pravinsharma15k-ops/ESP32-C3-Sensor-Board/ESP32-project/image/Screenshot from 2026-10-27 00-12-24.png

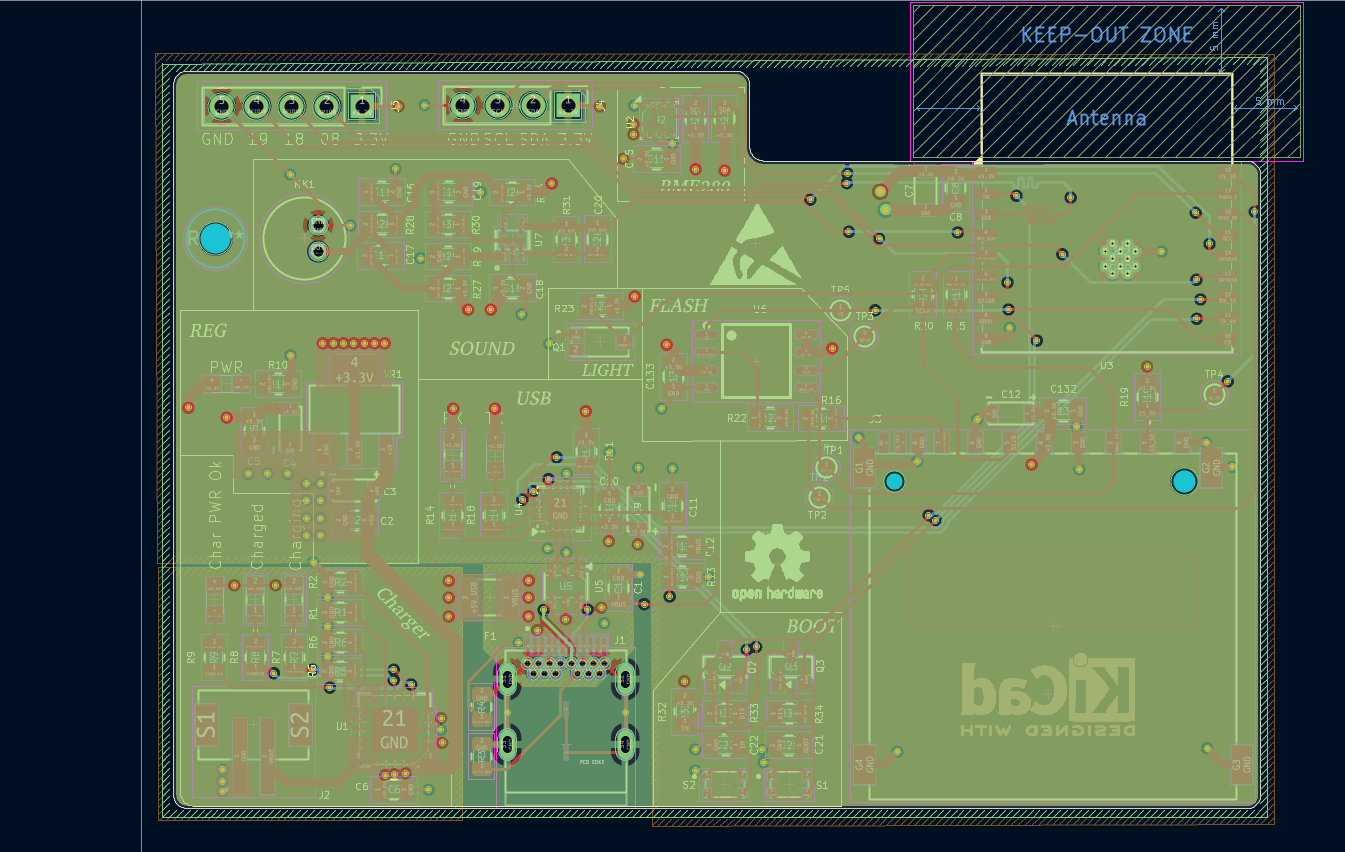
ESP32-project/image/Screenshot from 2026-10-27 00-12-24.png
