pravinsharma15k-ops/ESP32-C3-Sensor-Board/image/Screenshot from 2026-10-26 23-48-33.png

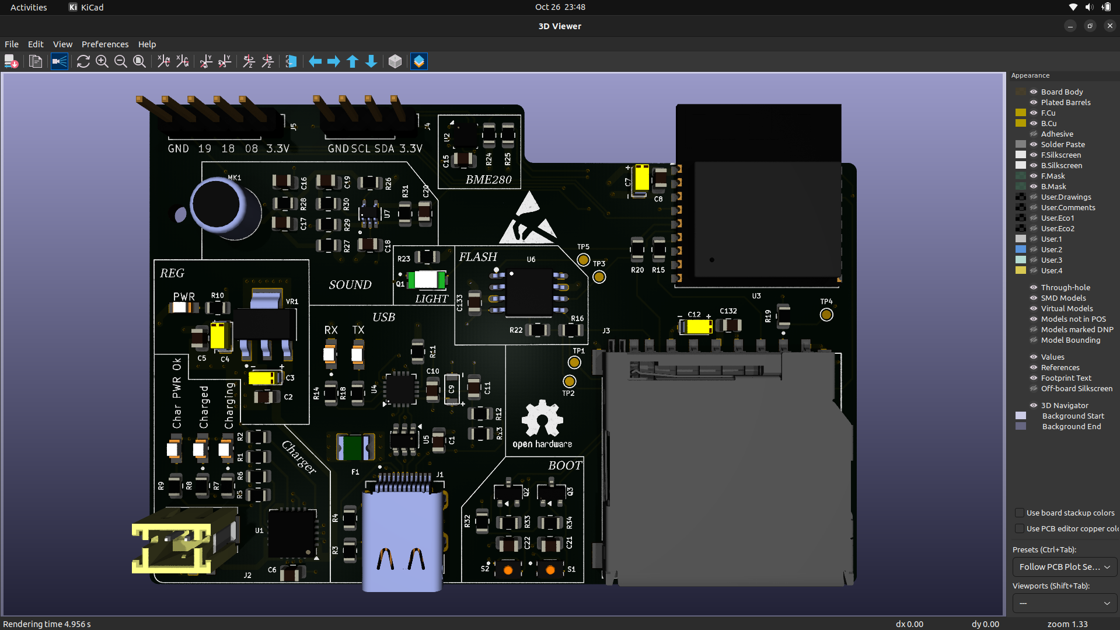
image/Screenshot from 2026-10-26 23-48-33.png
