pravinsharma15k-ops/ESP32-C3-Sensor-Board/image/Screenshot from 2026-10-27 00-13-16.png

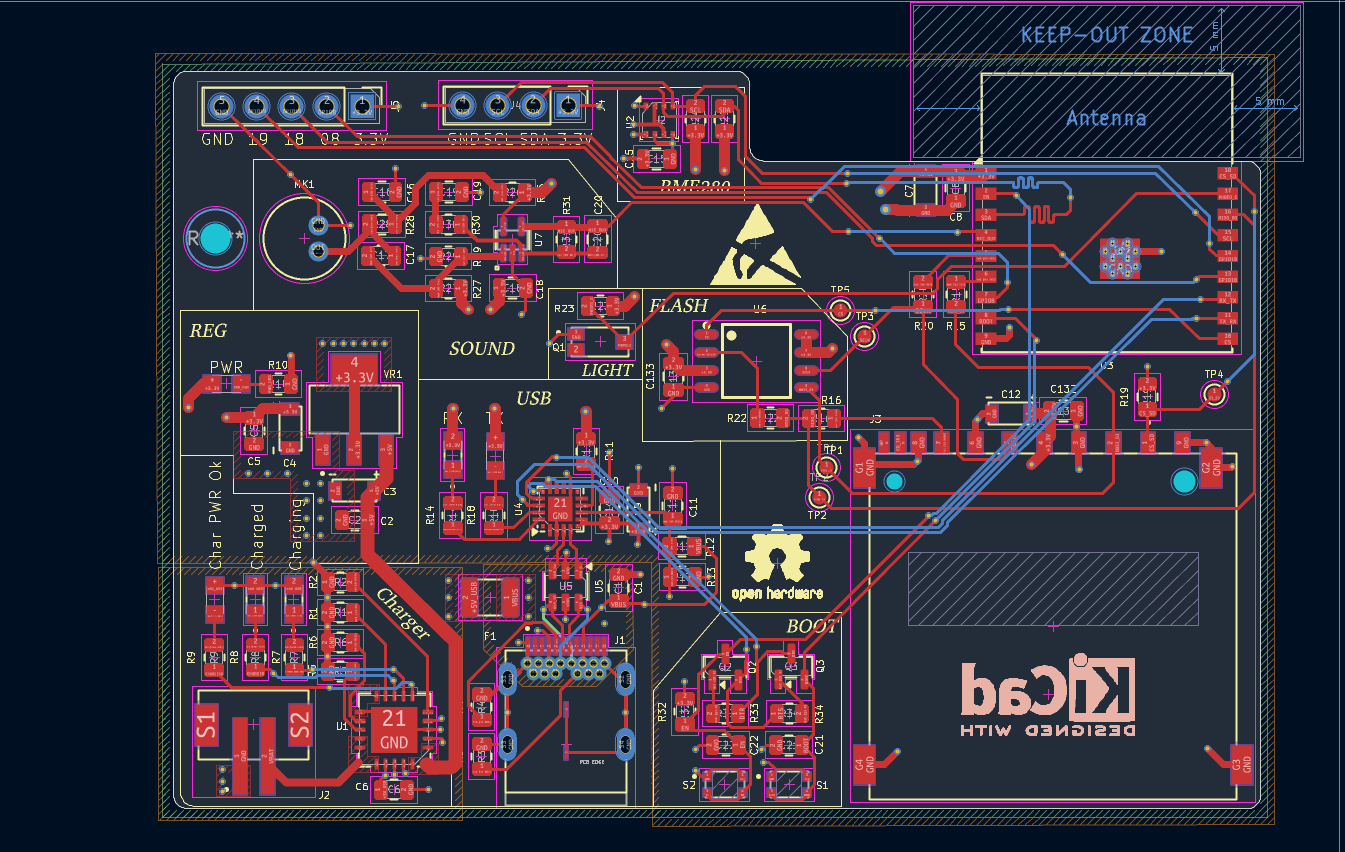
image/Screenshot from 2026-10-27 00-13-16.png
