pravinsharma15k-ops/ESP32-C3-Sensor-Board/Project_Library/Screenshot from 2026-10-22 23-52-42.png

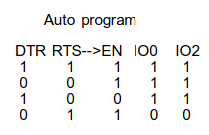
Project_Library/Screenshot from 2026-10-22 23-52-42.png
