pravinsharma15k-ops/ESP32-C3-Sensor-Board/Project_Library/3D-model/0ZCH0110AF2E.step

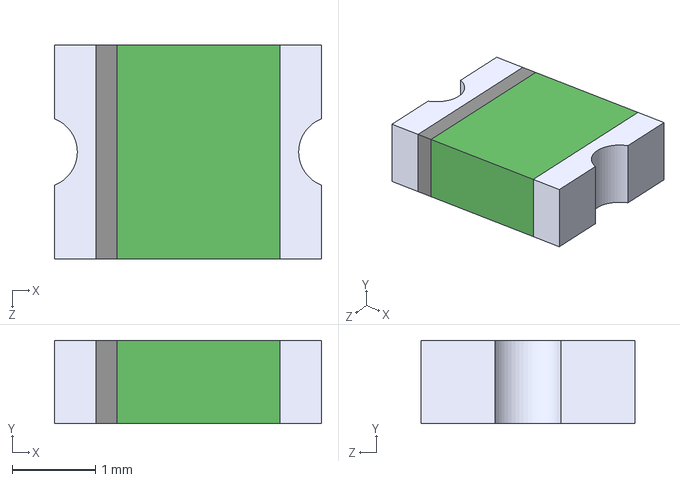
[picture p14: CAD file, 2026-10-26]
Project_Library/3D-model/0ZCH0110AF2E.step
3.21 x 1.00 x 2.58 mm
