pravinsharma15k-ops/ESP32-C3-Sensor-Board/Project_Library/3D-model/CMC-5042PF-AC.step

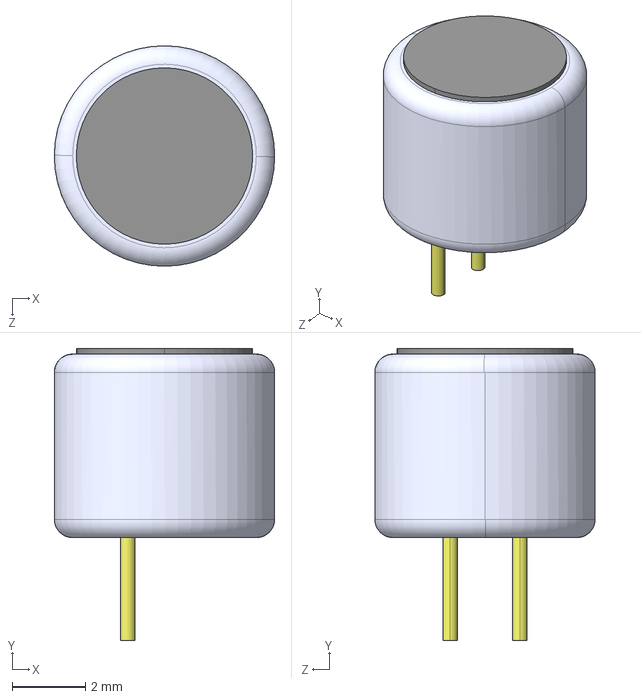
[picture p15: CAD file, 2026-10-26]
Project_Library/3D-model/CMC-5042PF-AC.step
6.00 x 7.95 x 6.00 mm
