pravinsharma15k-ops/ESP32-C3-Sensor-Board/ESP32-project_log_missing3Dmodels.txt

[('U4', '/usr/share/kicad/3dmodels/Package_DFN_QFN.3dshapes/SiliconLabs_QFN-20-1EP_3x3mm_P0.5mm_EP1.8x1.8mm.step')]
