pravinsharma15k-ops/ESP32-C3-Sensor-Board/ESP32-project.pdf

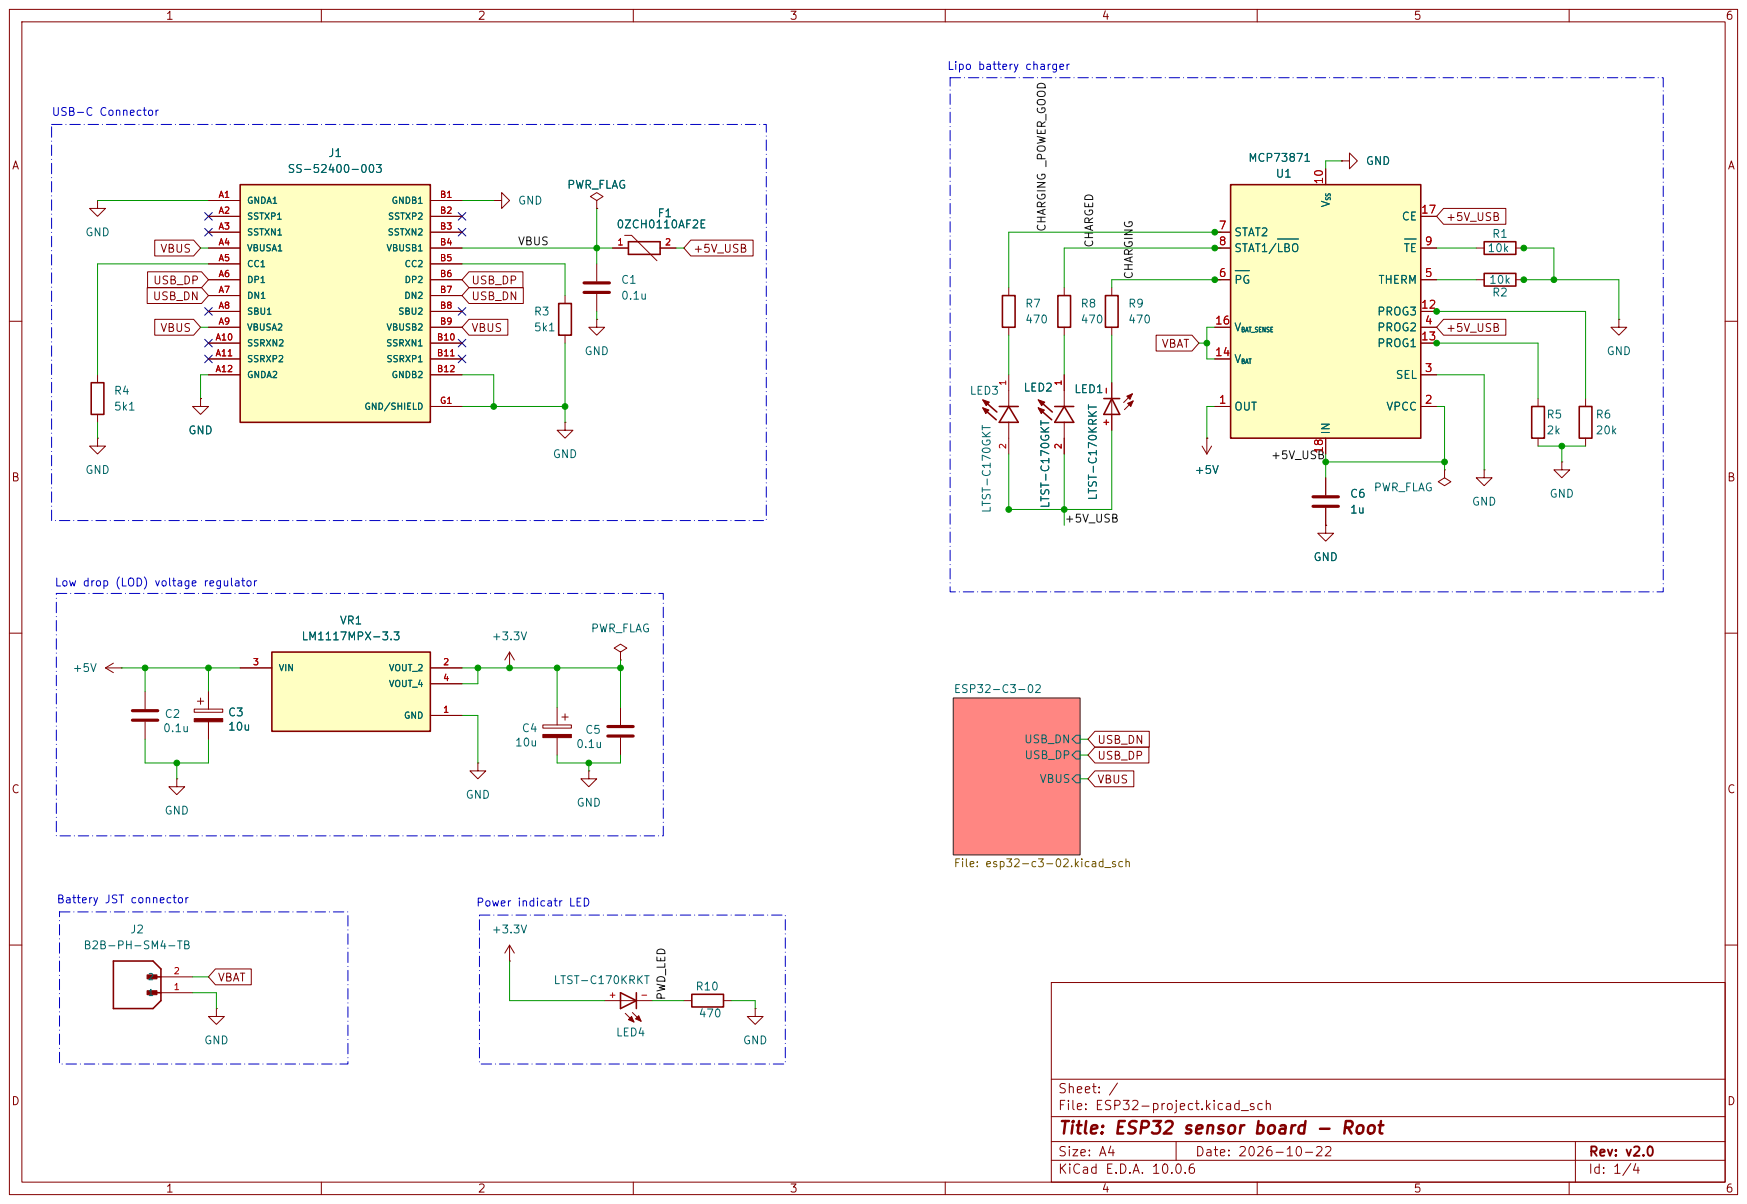
[picture p16: page 1]

STAT1/LBO 8

VBAT 14

Low drop (LOD) voltage regulator

Sheet: /
File: ESP32-project.kicad_sch
Title: ESP32 sensor board - Root

Size: A4 | Rev: v2.0
KiCad E.D.A. 10.0.6 | Id: 1/4

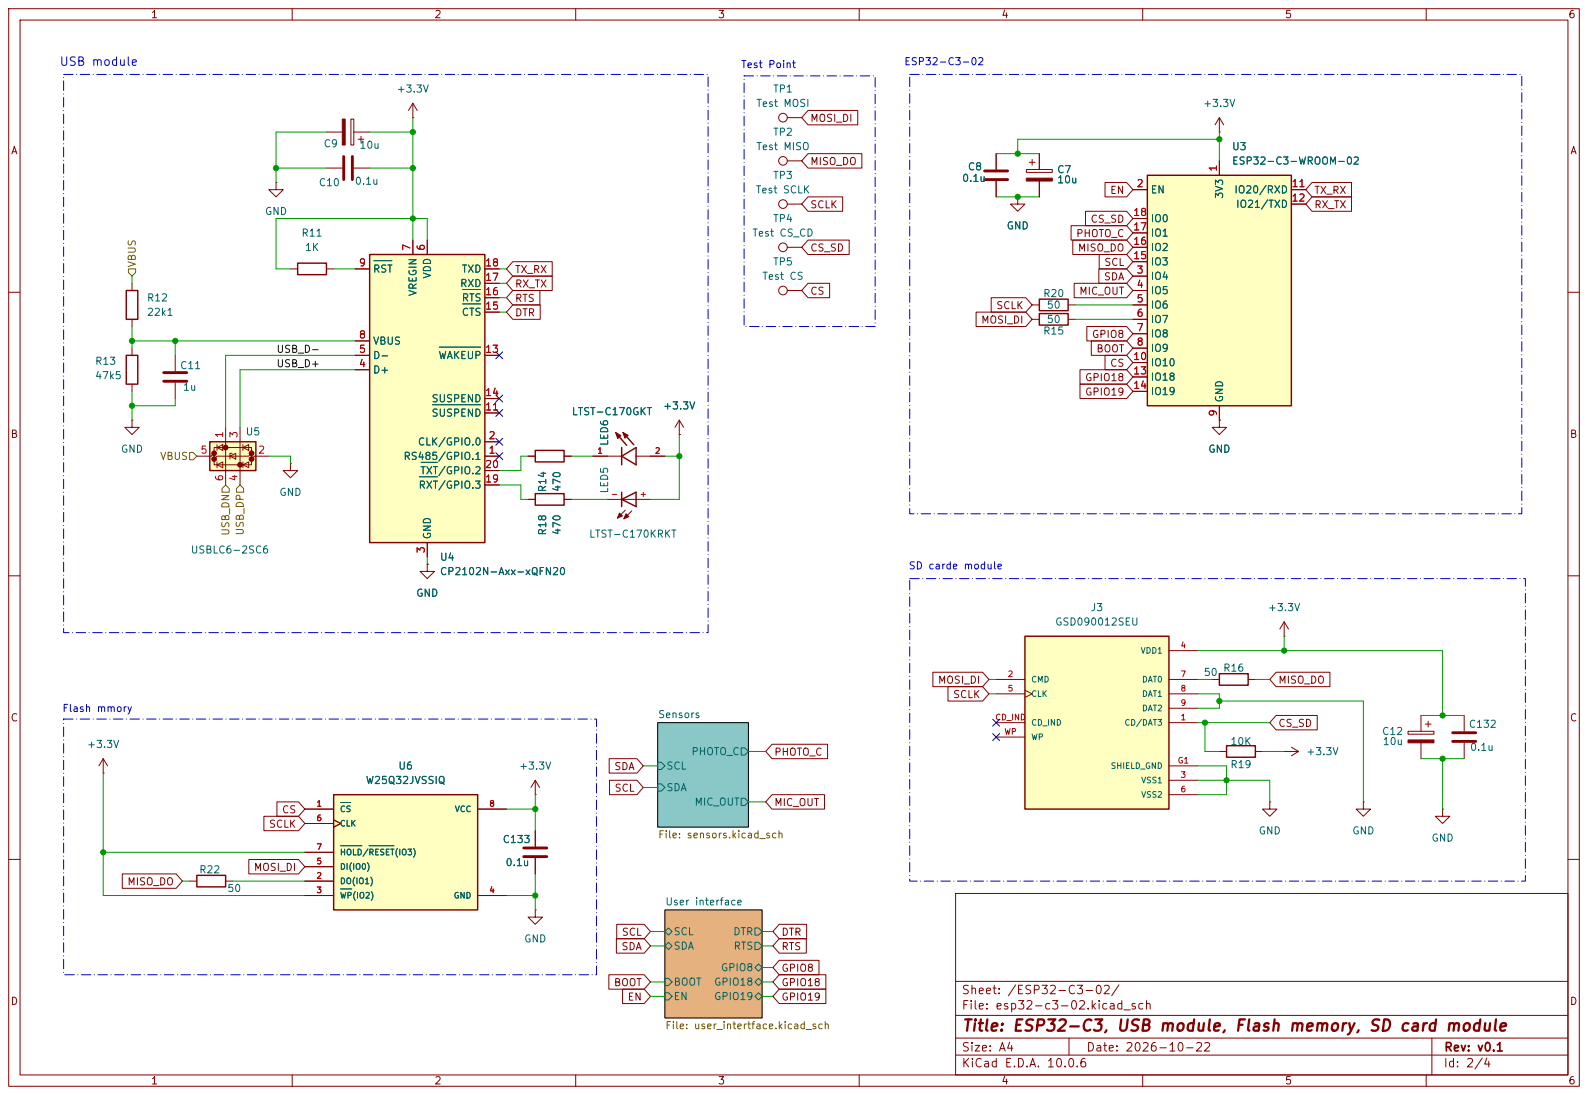
[picture p17: page 2]

SUSPEND 14 CTS 15 RTS 16 RXD 17 TXD 18 RXT/GPIO.3 19 TXT/GPIO.2 20 U4CP2102N-Axx-xQFN20 USB_DN USB_DP
Test CS R22

USB_D-
BOOT SDA SDA CS USB_D+

SCL SDA Sensors File: sensors.kicad_sch C11

SCL SDA User interface

File: esp32-c3-02.kicad_sch
Title: ESP32-C3, USB module, Flash memory, SD card module

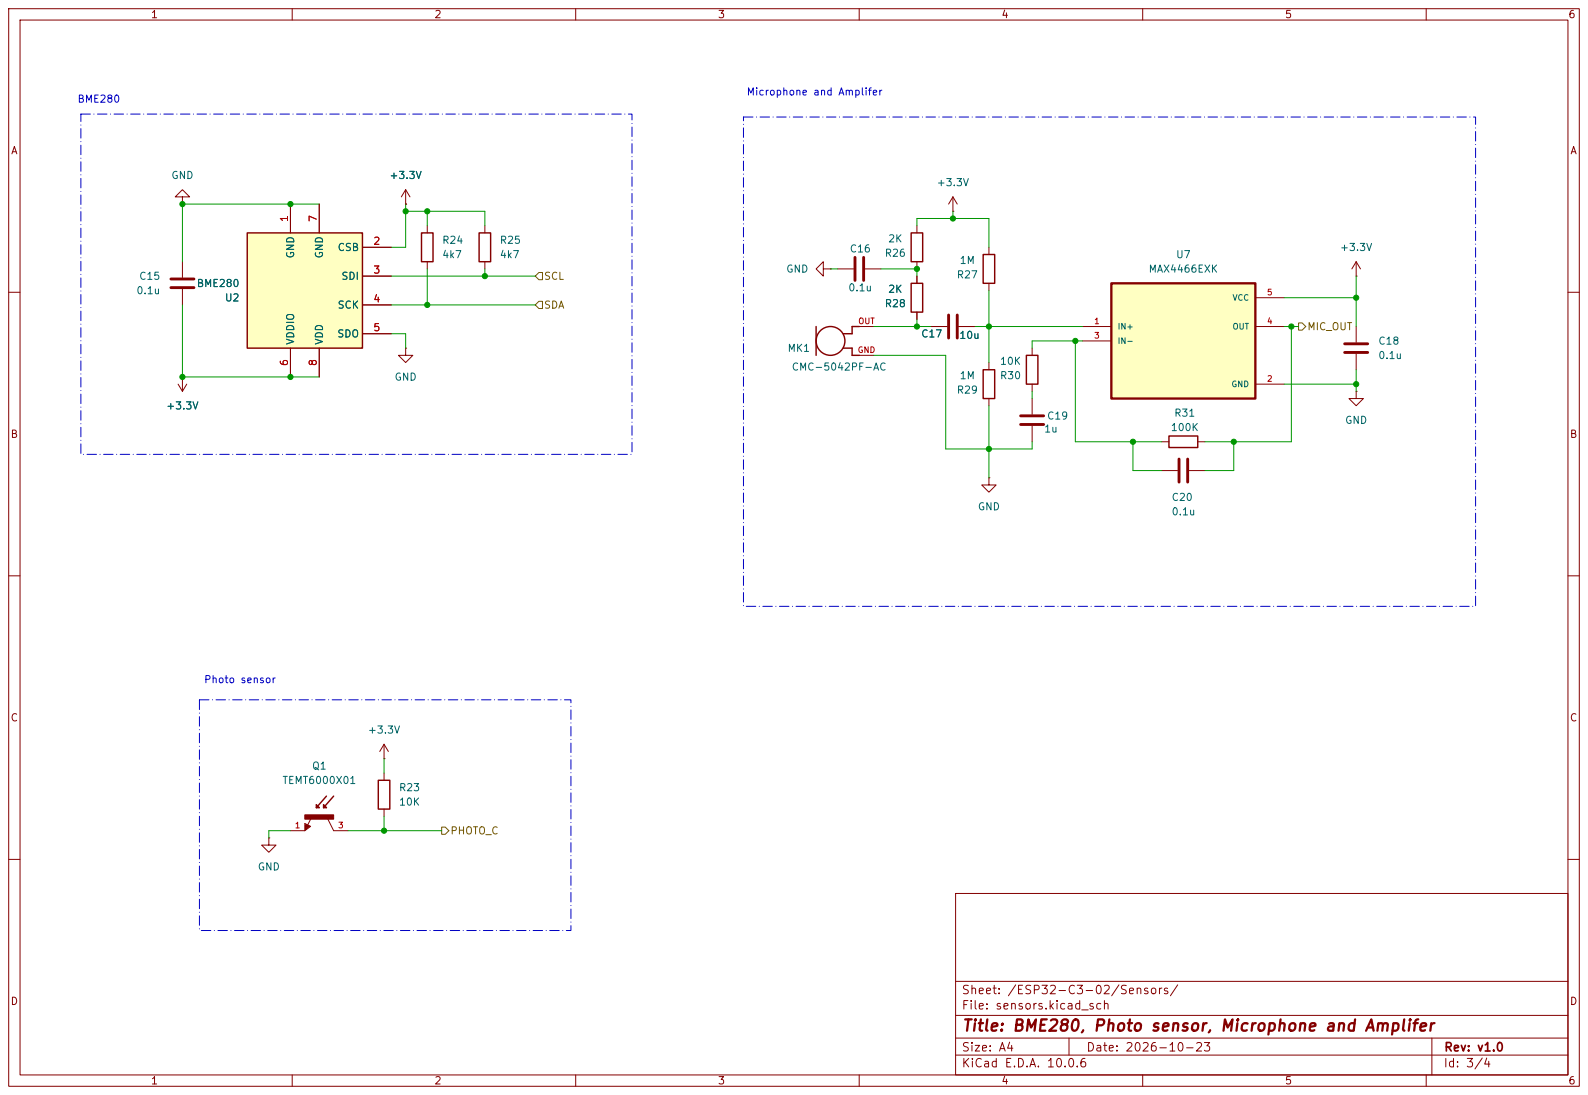
[picture p18: page 3]

GND OUT MK1 CMC-5042PF-AC

Sheet: /ESP32-C3-02/Sensors/
File: sensors.kicad_sch
Title: BME280, Photo sensor, Microphone and Amplifer

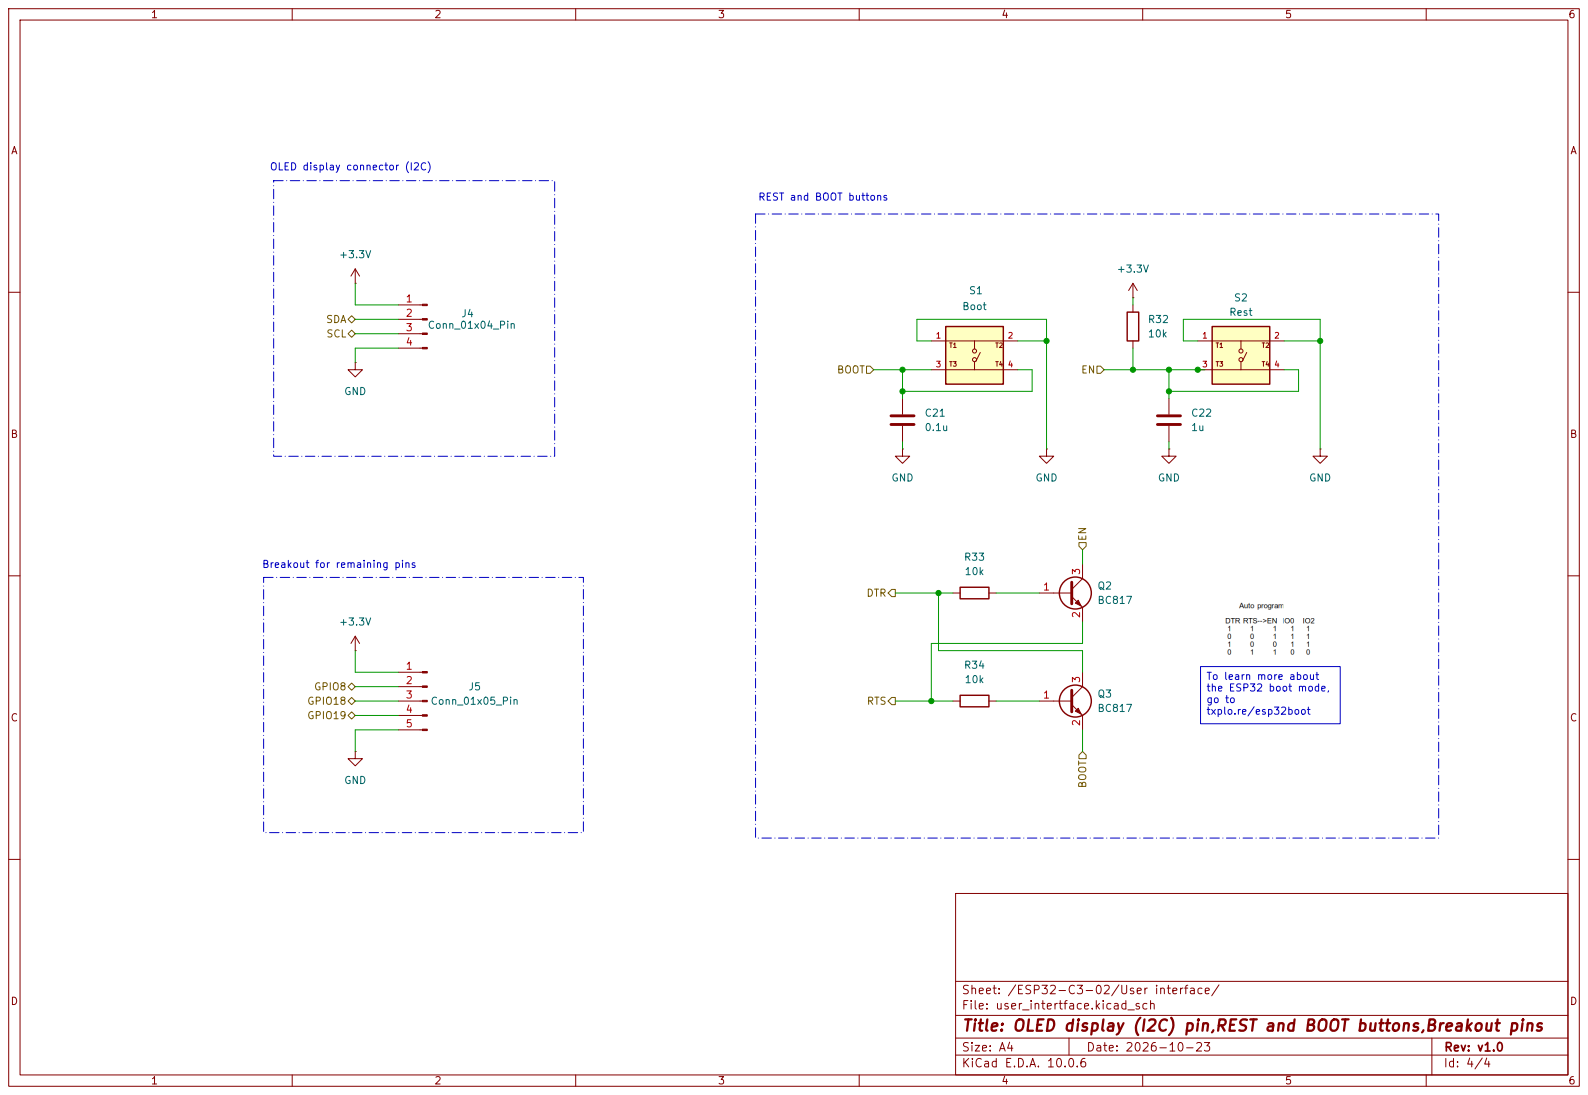
[picture p19: page 4]

REST and BOOT buttons OLED display connector (I2C) Breakout for remaining pins

To learn more about
the ESP32 boot mode, go to

Sheet: /ESP32-C3-02/User interface/
File: user_intertface.kicad_sch
Title: OLED display (I2C) pin,REST and BOOT buttons,Breakout pins
