pravinsharma15k-ops/ESP32-C3-Sensor-Board/(commit log)

2026-10-26 Add ESP32-C3 sensor board KiCad project
2026-10-26 Organize ESP32 project folder
